Spacesix-andalucia/Cansat-2021/Diseño/CanSat/prototipo.jpg

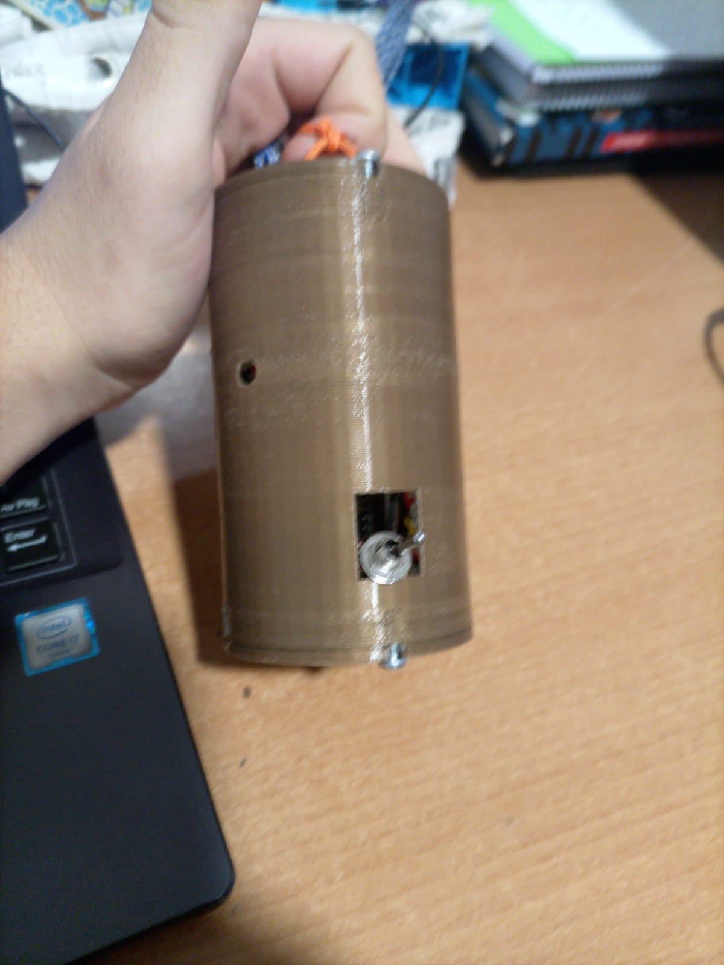
Diseño/CanSat/prototipo.jpg
