Spacesix-andalucia/Cansat-2021/Diseño/CanSat/circuito.jpg

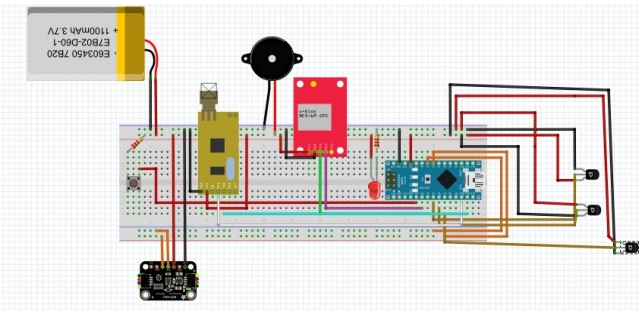
Diseño/CanSat/circuito.jpg
