Spacesix-andalucia/Cansat-2021/Diseño/Paracaidas/B6.jpg

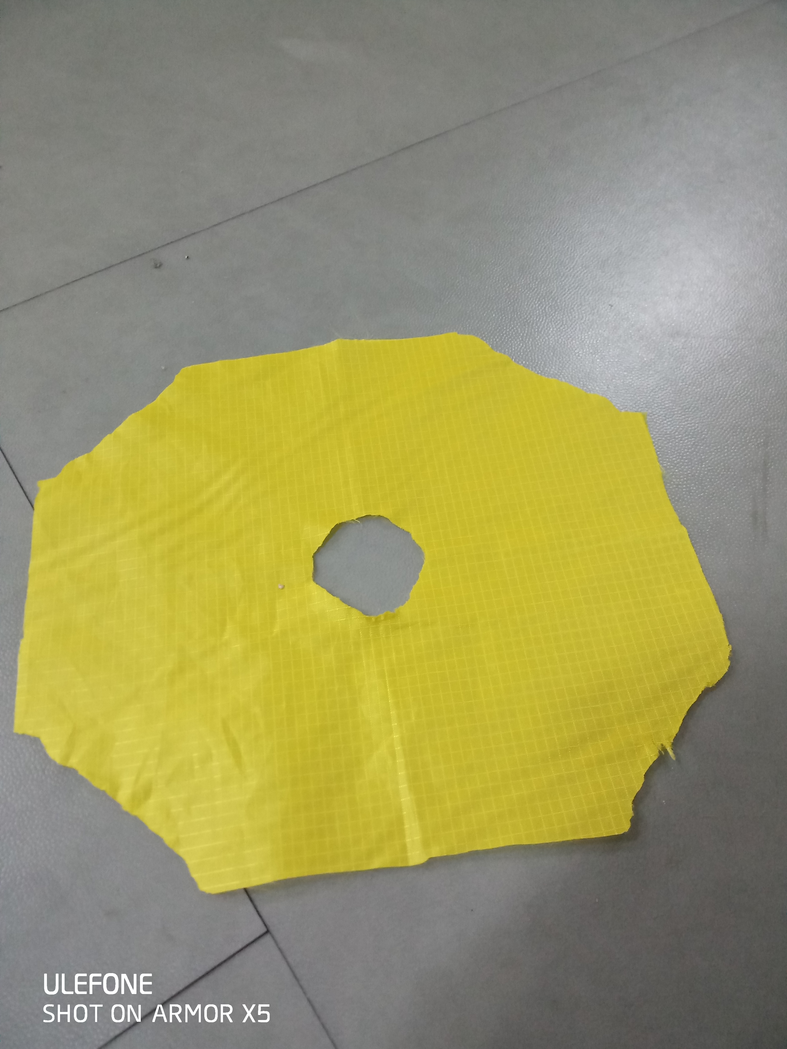
Diseño/Paracaidas/B6.jpg
